gibonni/sriod-navigation/README.md

This is my part of bachelor thesis project.
