gibonni/sriod-navigation/Praćenje_magnetskog_otiska_mobilnim_robotom.pdf

### SVEUCILIŠTE U ZAGREBU ˇ FAKULTET ELEKTROTEHNIKE I RACUNARSTVA ˇ

### ZAVRŠNI RAD br. 72

# Pracenje magnetskog otiska ´

# mobilnim robotom

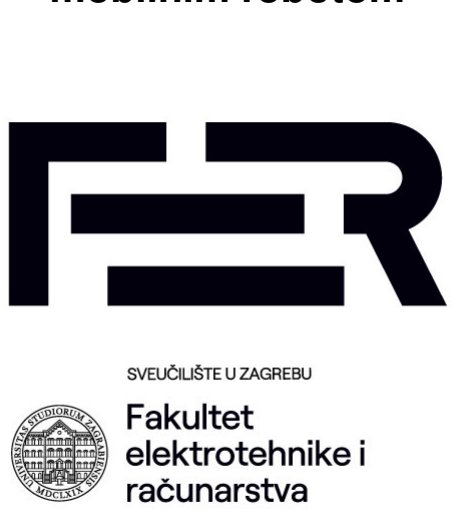
[picture p1: figure]

### Gabrijel Bioci ˇ c´

Mentor: izv. prof. dr. sc. Matko Orsag

Zagreb, ožujak 2025.

Pracenje magnetskog otiska mobilnim robotom | Gabrijel Bio ´ | ciˇ c´

## SADRŽAJ

1. Uvod | v
2. Korišteni hardver i softver | vi
3. Eksperimenti | xi
4. Zakljucak | xix ˇ
5. Sažetak | xx
Literatura | xxi
iv | SADRŽAJ

Gabrijel Biociˇ c | Pra ´ | cenje magnetskog otiska mobilnim robotom ´

# 1. Uvod

Navodenje mobilnih robota u prostoru mogu ¯ | ce je izvesti razli ´ | citim metodama. Jedna ˇ
od pouzdanih metoda koja zahtjeva intervenciju u prostoru je pracenje linije kamerom ´ na mobilnom robotu [2]. U ovom zadatku potrebno je izvesti ovaj kanonski problem upravljanja mobilnim robotom preko povratne veze temeljene na magnetskom polju. Potrebno je modificirati postojeci mobilni robot tako da ga se opremi senzorom za ´ mjerenje magnetskog polja. Robot ce morati pratiti kontinuiranu stazu sastavljenu od ´ permanentnih magneta.
Krajnji cilj zadatka je riješiti problem pracenja magnetskog otiska. Rješavanje tog ´
zadatka kasnije bi omogucilo primjenu i prilagodbu ovog rješenja na sli ´ | cne probleme. ˇ
Neki od primjera bi bili oznacavanje stanice za punjenje magnetima, ograni ˇ | cavanje po- ˇ
drucja rada magnetima kao dodatna zaštita u navigiranju samog robota u ograni ˇ | cenom ˇ
prostoru. Takoder prilikom vožnje snijeg ili bilo kakva druga sli ¯ | cna prirodna pojava ˇ
može omesti vec postoje ´ | ce sustave koji se oslanjaju na vidljive zapreke. Ti sustavi ´
mogu se unaprijediti tako da se doda i sustav pracenja magnetskog polja te se doda ´ zapreka magnetskom trakom, tako se sustav može navigirati iz više izvora [7].
POGLAVLJE 1. UVOD | v

# 2. Korišteni hardver i softver

## 2.1. Hardver

### 2.1.1. Gradiometar

Gradiometar je razvijen na Fakultetu elektrotehnike i racunarstva u laboratoriju LA- ˇ RICS [6]. Za mjerenje magnetskog polja koristi SRIOD metodu koja osim iznosa magnetskog polja može mjeriti i orijentaciju. Podatke koji se dobiju sa senzora odgo-
varaju fizikalnoj velicini gusto ˇ | ce magnetskog polja. Mjerenja CTL i CTR se koriste ´
kao ulaz u regulator. Ta mjerenja su dobivena s razlicitih pozicija na gradiometru te ˇ nam omogucuju orijentaciju u prostoru. Kako bi nam ti podaci bili korisni treba nam ´ njihova razlika.
errorz = CT L − CT R | (2.1)

Razlika iz jednadžbe (2.1) može se koristiti kao pomak robota u odnosu magnetsko polje u lijevo ili desno ovisno o predznaku rezultata. Ta brojka se kasnije koristi za racunanje potrebne brzine rotacije robota. ˇ
Senzor koristi UDP komunikaciju spojenu preko ethernet kabela na robotovo racu- ˇ nalo. Prilikom postavljanja gradiometra važno je obratiti pažnju na smjer. Na njemu je

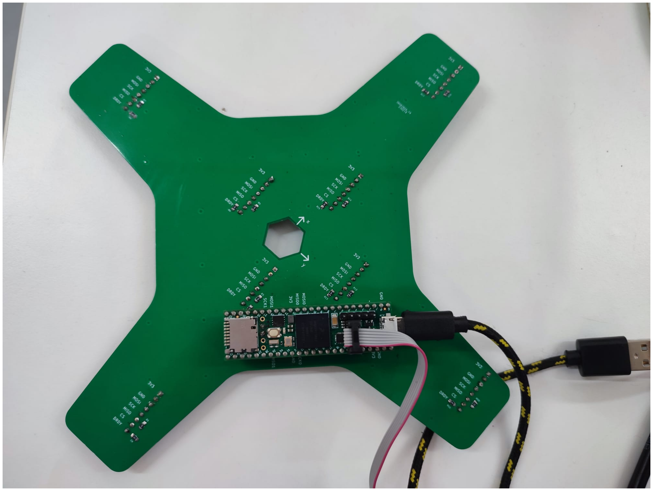
[picture p2: figure]
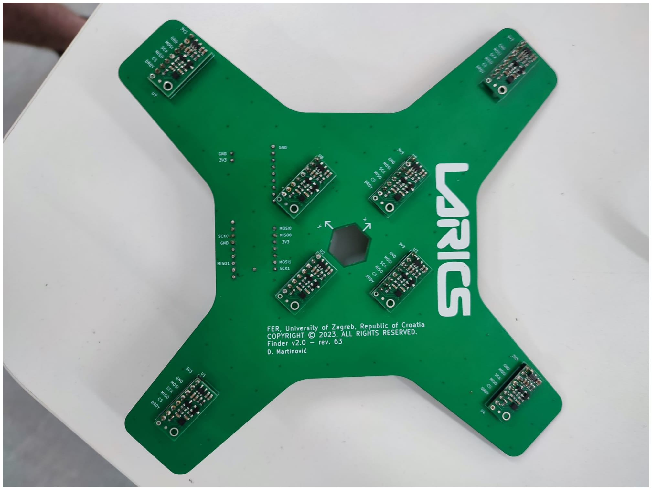
[picture p3: figure]

(a) Gornja strana s ugradbenim racunalom. ˇ | (b) Donja strana sa senzorima.

Slika 2.1: Gradiometar korišten u eksperimentima.

oznacen pozitivan smjer ˇ | x i pozitivan smjer y. Algoritam razvijen u ovom radu pret-
postavlja da se x os gradiometra postavlja u pozitivnom smjeru kretanja robota prema
vi | POGLAVLJE 2. KORIŠTENI HARDVER I SOFTVER

naprijed. Osim navedenih CTL i CTR moguce je koristiti CTU i CTD što funkci- ´ onira na slican na ˇ cin kao CTL i CTR. Razlika CTU i CTD nam govori koliko je izvor ˇ magnetskog polja udaljen po x osi. Prilikom eksperimenata postavljena je konstantna brzina prema naprijed te se koristi error_z iz jednadžbe (2.1) za skretanje lijevo ili desno.

### 2.1.2. Mobilni robot

Robot koji se koristi za eksperimente je Scout Mini od Agile X Robotics [8]. Dimenzije mobilnog robota su 612×580×245 mm, dok mu je masa 23 kg. Za komunikaciju

koristi Standard can.232 serial port te ga je moguce kontrolirati preko cmd_vel topica ´
u ROS-u. Prilikom izvodenja eksperimenata koristili su se omnidirekcionalni kota ¯ | ci. ˇ

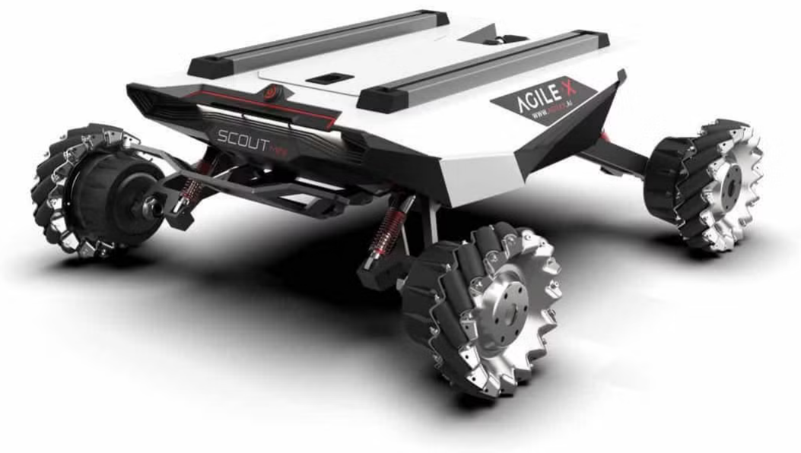
[picture p4: figure]

Slika 2.2: Scout Mini robot s omnidirekcionalnim kotacima. ˇ

### 2.1.3. Neodimijski magneti i staza

Traka 2.4 koju robot prati složena je od niza paralelnih magneta koji cine stazu ˇ koju robot mora pratiti. Svaki par magneta je udaljen 5 centimetara od drugog para magneta. Magneti [5] su zalijepljeni za pod ljepljivom trakom 2.3a. Razlog korištenja neodimijskih magneta je njihova velika snaga te zbog toga mogu lakše nadjacati ˇ smetnje.

POGLAVLJE 2. KORIŠTENI HARDVER I SOFTVER | vii

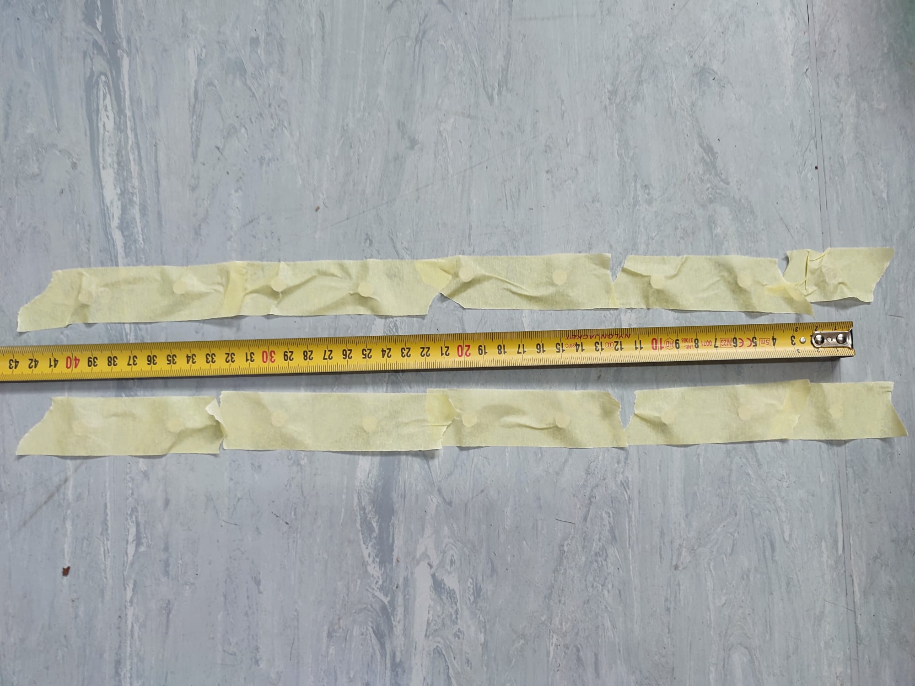
[picture p5: figure]

(a) Staza sa zaljepljenim neodimijskim magne-

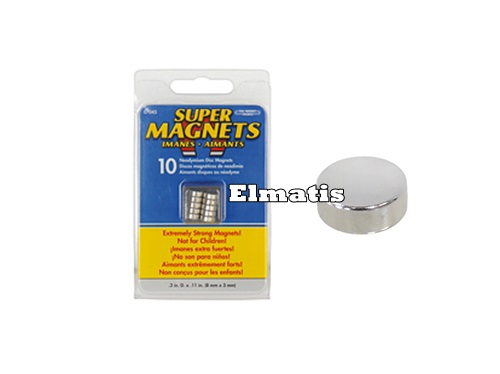
[picture p6: figure]

tima. | (b) Neodimijski magneti.

Slika 2.3: Slike staze i magneta.

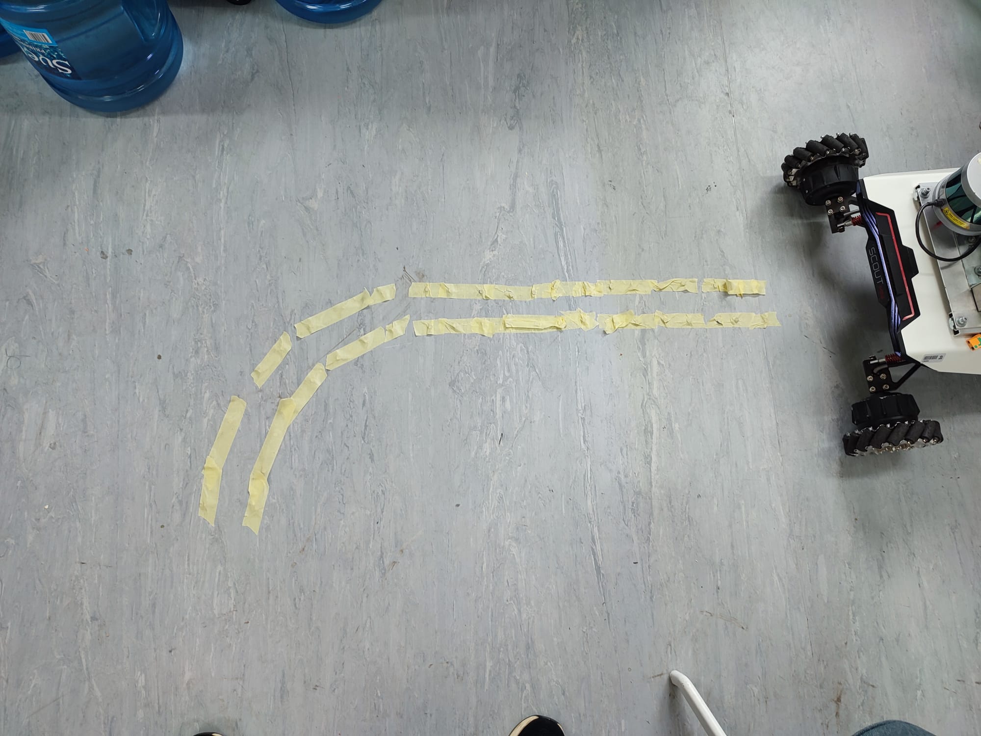
[picture p7: figure]

Slika 2.4: Staza s robotom

viii | POGLAVLJE 2. KORIŠTENI HARDVER I SOFTVER

### 2.1.4. Nastavak za gradiometar

Gradiometar stoji ispod samoga robota te od tamo mjeri sve podatke. Kako bi on tamo stajao dizajniran je nastavak prikazan na Slici 2.5c na koji se senzor može staviti i ucvrstiti. Modelirana su dva dijela. Nastavak koji se može staviti na robota te matica ˇ koja se stavlja na nastavak kako bi senzor ostao na mjestu [3]. Nastavci su dizajnirani u Autodesk Fusion 360 [1].

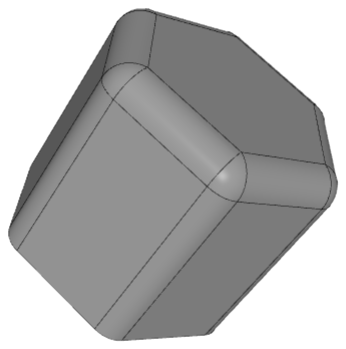
[picture p8: figure]
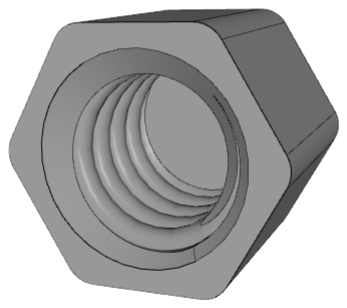
[picture p9: figure]

(a) Matica s vanjske strane. | (b) Matica s unutarnje strane.

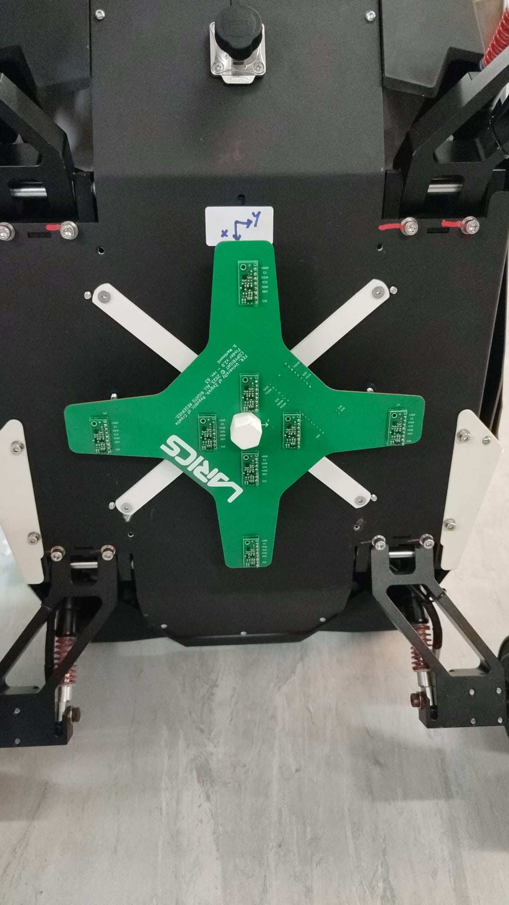
[picture p10: figure]
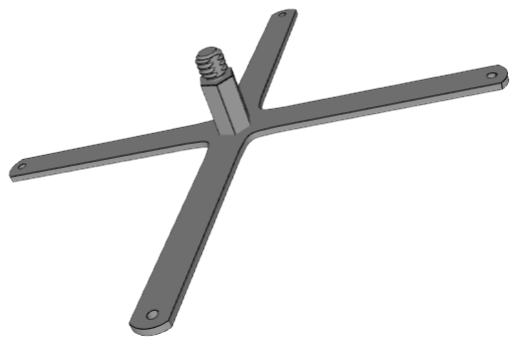
[picture p11: figure]

(c) Nastavak za gradiometar. | (d) Gradiometar na robotu.

Slika 2.5: Slike matice i nastavka za gradiometar.

POGLAVLJE 2. KORIŠTENI HARDVER I SOFTVER | ix

## 2.2. Softver

### 2.2.1. ROS

Robotski operacijski sustav [4] je skup softverskih biblioteka koji služi kako bi se
lakše izradivalo aplikacije za upravljanje robotima. Omogu ¯ | cuje jednostavan na ´ | cin za ˇ
implementaciju autonomnog nacina rada. Korištena verzija ROS-a za ovaj projekt je ˇ ROS Noetic. Napisane su dvije skripte od kojih jedna šalje podatke sa senzora na ROS topic, te druga te podatke obraduje i pretvara ih u cmd_vel. Za potrebe ovog ¯ projekta definiran je novi topic SRIOD_data na koji se šalju mjerenja senzora 2.1.1 pod nazivima CTU, CTD, CTR i CTL. S tog topica uzimaju se podatci koji se obraduju ¯ i šalju na cmd_vel koji robot 2.1.2 prima te se krece sukladno tim podatcima. ´

### 2.2.2. PID kontroler

PID (proporcionalni-integralni-derivacijski) kontroler je vrsta povratne veze koja se koristi u automatskoj regulaciji sustava kako bi se postigao željeni izlaz ili kontrola. Proporcionalni dio regulatora (Kp) reagira na trenutnu vrijednost koju sustav dobiva
u odnosu na željenu vrijednost. Što je veca greška do ja ´ | ce djeluje. Obi ˇ | cno ima najve ˇ | cu´

vrijednost. Integracijski dio regulatora tijekom vremena akumulira pogrešku i koristi
se za eliminaciju preostale greške. Omogucuje preciznije postavljanje na kona ´ | cnu ˇ
vrijednost, ali zbog njega sustav sporije reagira. Integracijski dio regulatora dodaje se po potrebi, ako želimo i kako greška u stacionarnom stanju nebi postojala. Derivacijski
dio regulatora predvida grešku u budu ¯ | cnosti u odnosu na trenutnu promjenu greške. ´
Koristi se kako bi se ubrzala reakcija sustava na grešku. Ovaj dio je jako osjetljiv te uvodi kašnjenja.
U ovome rješenju koristi se samo proporcionalni dio regulatora jer je pokazao da za potrebe eksperimenta dovoljno dobro prati referencu. S obzirom na velike kolicine ˇ šuma, derivacijski clan se isto ne koristi. ˇ

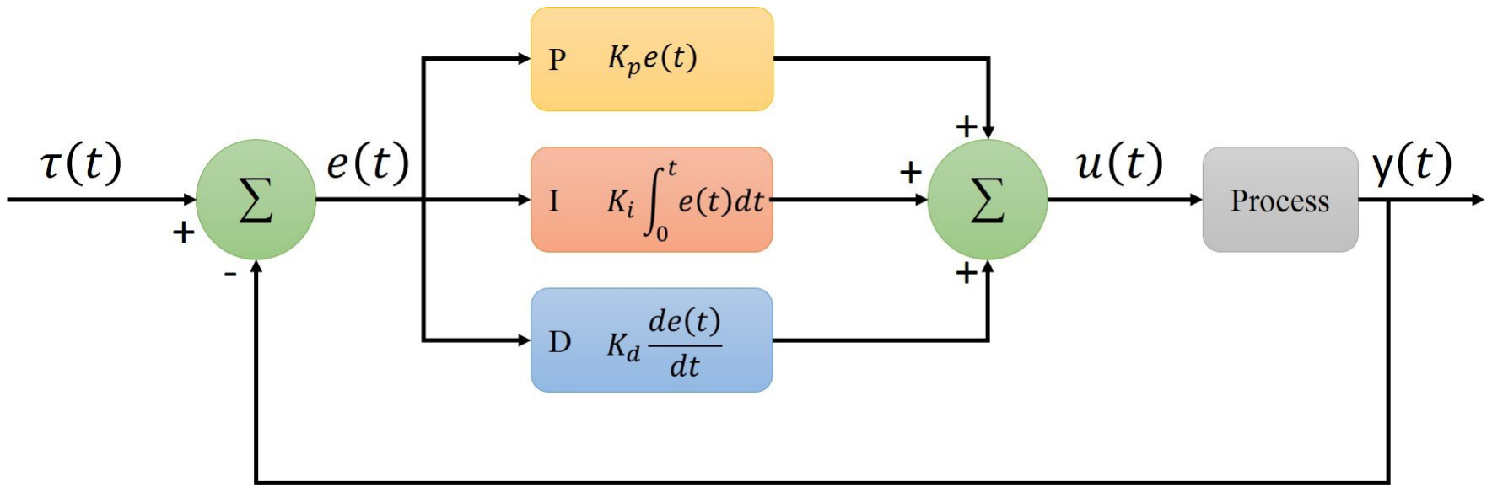
[picture p12: figure]

Slika 2.6: Blok dijagram PID kontrolera.

x | POGLAVLJE 2. KORIŠTENI HARDVER I SOFTVER

# 3. Eksperimenti

## 3.1. Postav eksperimenta

### 3.1.1. Postavljanje gradiometra

Gradiometar je postavljen tocno ispod robota 3.1. To mjesto je najprikladnije i naj- ˇ jednostavnije za postaviti senzor. Za senzor je dizajniran prikladan nastavak kako bi ga
se moglo prikvaciti za robota 2.5. U sljede ˇ | cim eksperimentima se ne koriste magneti iz ´
literature nego neki drugi znatno slabiji te nepoznatog sadržaja. Njih je više spojeno te
cine cilindar te stoga imaju ja ˇ | cu snagu skupa nego jedan neodimijski magnet. Rezultati ˇ
ovih eksperimenata koriste se u softverskoj obradi šuma.

Slika 3.1: Senzor montiran na robotu.

Senzor je jako osjetljiv na promjene te stoga osjetljiv i na šum. Zbog toga su provedena mjerenja kako bi se vidjelo na koji nacin utje ˇ ce okolina, elektromotori na ko- ˇ tacima te to usporedili s mjerenjima kada se senzor nalazi blizu magneta. Provedeni ˇ eksperimenti su samo vožnja po podu, podizanje robota u zrak i kretnje kotaca, stajanje ˇ robota uz pomicni magnet u zraku i na podu te vožnja preko magneta. Iz tih ekspe- ˇ

POGLAVLJE 3. EKSPERIMENTI | xi

rimenata zakljuceno je da je omjer mjerenja smetnje i mjerenja s magnetom dovoljno ˇ velik da senzor može ostati ispod robota i biti korišten za navigaciju.

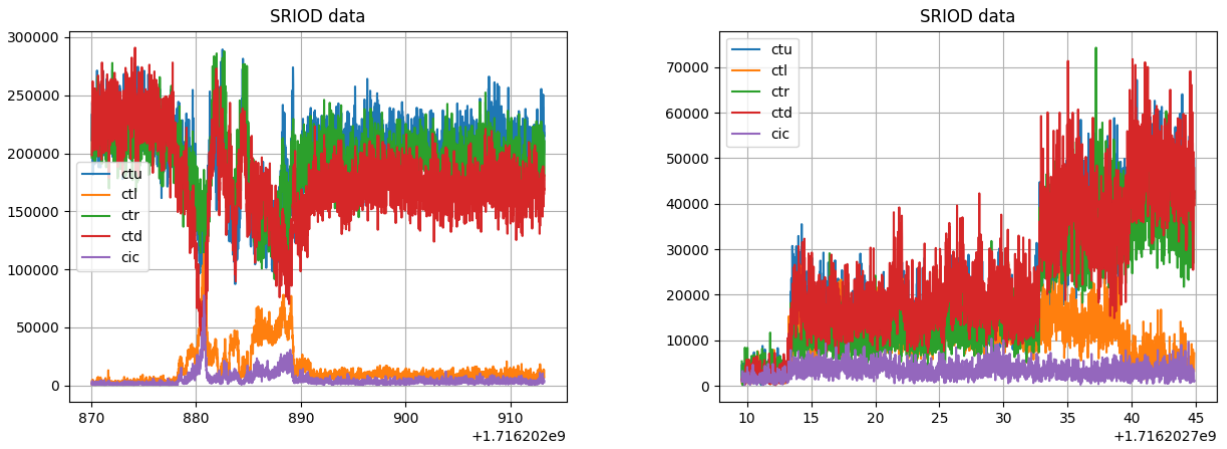
[picture p13: figure]

(a) Vožnja po podu. | (b) Robot u zraku.

Slika 3.2: Mjerenja šuma motora robota.

Na slici 3.2b može se vidjeti da dok je robot u zraku maksimalna razina šuma dolazi na razinu do oko 8·10⁵ dok u eksperimentu vožnje po podu 3.2a dolazi i do 3·10⁶
. Može
se zakljuciti da bez prisutnosti nekog magnetskog materijala šum ne ˇ | ce prije ´ | ci razinu ´
4 · 10⁶
te kasnije u upravljanju sva mjerenja koja su manja od toga se mogu zanemariti. Sljedeci provedeni eksperimenti su napravljeni kako bi se provjerio utjecaj magneta ´ na senzor te kolika je razlika izmedu mjerenog utjecaja magneta i šuma. Robot je bio ¯ odignut od poda na dovoljnu razinu da okolina ne utjece na signal te se magnetom ˇ prošlo ispod robota oko podrucja senzora. ˇ

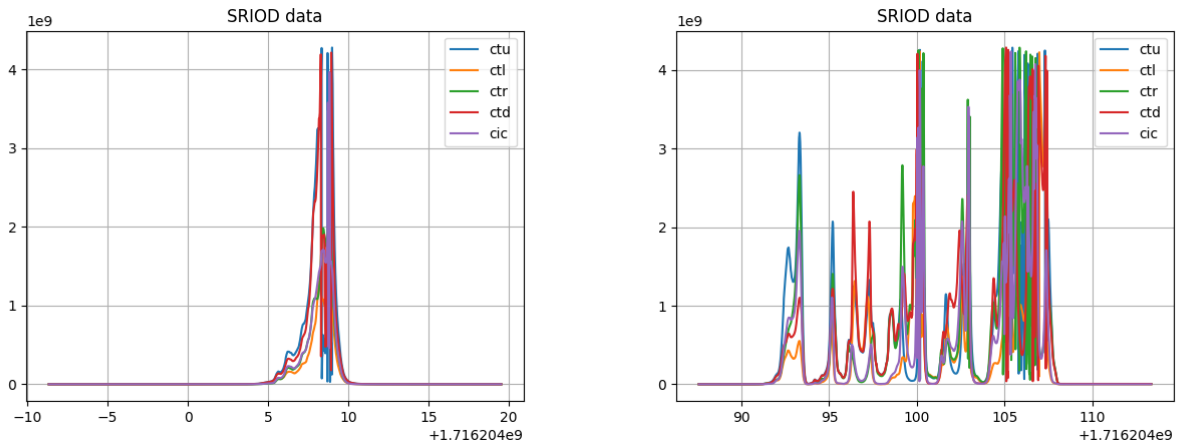
[picture p14: figure]

(a) Zrak s magnetom. | (b) Zrak s pomicnim magnetom. ˇ

Slika 3.3: Eksperiment s magnetom i robotom u zraku.

Eksperiment 3.3a proveden je tako da je robot bio statican podignut u zrak dok se ˇ magnet približavao do senzora i nazad. Iz podataka se može vidjeti neka maksimalna vrijednost mjerenja dolazi do razine 4.5 · 10⁹
. te da magnet utjece dovoljno jako da ˇ
xii | POGLAVLJE 3. EKSPERIMENTI

šum nije relevantan. Drugi eksperiment koji je proveden 3.3b je slican, samo osim ˇ približavanja magneta senzoru magnet se pomicao u raznim smjerovima kako bi se
vidjelo da magnet ne utjece previše na senzor i da može mjeriti razliku na razli ˇ | citim ˇ
pozicijama. Ovdje takoder mjerenja dosežu neku maksimalnu vrijednost od ¯ | 4.5 · 10⁹
te
je zakljuceno da senzor može raspoznati poziciju magneta. Idealan omjer šuma 3.1.1 i ˇ
signala u ovom slucaju iznosi 30.51dB što daje odli ˇ | cne uvjete za navigaciju robotom. ˇ
Sljedeci eksperimenti koji su provedeni su sli ´ | cni, ali s robotom na podu. Ovi eksperi- ˇ
menti su provedeni kako bi se vidjelo kakav ce omjer šuma i signala biti u stvarnom ´
slucaju kada ˇ | ce se robot sam voziti te upravljati mjerenjima dobivenog signala te ho ´ | ce´
li šum utjecati na putanju. Kao prvi eksperiment robot se vozi po podu se prelazi preko magneta kako bi se izmjerio signal te vidjela razlika izmedu signala pri vožnji ¯ bez magneta ispod robota te sa magnetom. Drugi provedeni eksperiment postavlja robota u stacionarno stanje te se magnet rukom pomice ispod senzora. Taj eksperiment ˇ se provodio kako bi se potvrdili rezultati prethodnog eksperimenta i konacno utvrdio ˇ omjer signala i šuma.

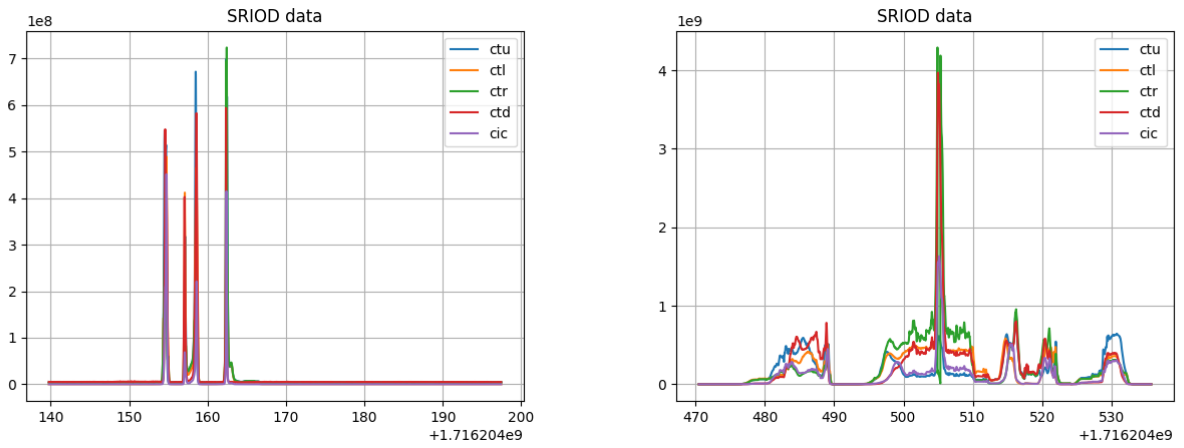
[picture p15: figure]

(a) Vožnja preko magneta. | (b) Približavanje magneta senzoru.

Slika 3.4: Eksperiment s magnetom i robotom na podu.

U eksperimentu vožnje preko magneta 3.4a možemo vidjeti da se vrlo jasno vidi kada robot prelazi preko magneta. U tim trenutcima signal dolazi do razine od 5.5 · 10⁸ do 7.5 · 10⁸ ovisno o tome koliko blizu je bio sam magnet senzoru. Takoder se ovdje ¯

vidi pad signala za red jedne velicine. Iz tih podataka omjer šuma 3.1.1 i signala iznosi ˇ 22.11dB za iznos signala 6.5·10⁸
što i dalje daje dobar omjer za autonomno upravljanje vozilom. U drugom eksperimentu 3.4b potvrduje se da je šum zanemariv u odnosu na ¯ signal kada se senzor nalazi u blizini magneta.
POGLAVLJE 3. EKSPERIMENTI | xiii

## 3.2. ROS i PID

Robot se upravlja preko cmd_vel topica te je za to napisana skripta SriodNaviga-
tion.py. Prvo je u ROS implementiran vec postoje ´ | ci kod za dobivanje podataka [6] sa ´
senzora te je za te podatke napisan poseban topic na koji ce se slati mjerenja. Podaci ´ se obraduju u skripti SriodNavigation.py u kojoj je implementiran PID kontroler te se ¯
kasnije šalju na cmd_vel. Iz sljedecih eksperimenata zaklju ´ | ceno je da je dovoljan samo ˇ
proporcionalni dio regulatora.

### 3.2.1. Staza

Staza 3.5b koju robot treba prijeci napravljena je od neodimijskih magneta zalijep- ´ ljenih trakom za pod. Svakih 5 cm postavljen je jedan par magneta. Na stazi postoji jedan ravan dio koji se kasnije nastavlja u luk. Za robota je potrebno da taj dio prode od ¯ pocetka do kraja bez da skrene u nekom drugome smjeru. Samo ravni dio staze koris- ˇ tio se za grubo odredivanje proporcionalnog dijela regulatora te se kasnije s dodanim ¯ zavijutkom preciznije odredio taj parametar.

(a) Staza sa neodimijskim magnetima. | (b) Staza s kružnim lukom.

Slika 3.5: Slike staze korištene u eksperimentima.

### 3.2.2. P regulator

P regulator reagira na trenutna mjerenja te je za njegovo odredivanje bitno na koji ¯ koliko se brzo robot krece. Za sporije linearno kretanje potrebna je manja vrijednost, ´
dok za vece brzine i ve ´ | ca vrijednost parametra. Za odre ´ | divanje K ¯ | p prvo je postav-
ljen brzina u pozitivnom x smjeru da bude konstantna. Cmd_vel.x je postavljen na
0.25. Zatim se pri toj brzini odredivao K ¯ | p. Provedeno je više mjerenja kako bi se naj-
preciznije odredila vrijednost parametra. Prilikom prikupljanja podataka uzimale su se
xiv | POGLAVLJE 3. EKSPERIMENTI

vrijednosti koje dolaze direktno sa senzora i s njima racunala greška 2.1 te sama greška ˇ koju je robot koristio.
Red velicine parametra prvo je odre ˇ | den empirijskim metodama dok robot nije mo- ¯
gao dovoljno dobro slijediti ravnu stazu magneta. Duljina staze je bila postavljena na
65 cm prilikom odredivanja parametra te je robot morao mo ¯ | ci pro ´ | ci cijelu duljinu staze ´
bez da promijeni smjer kretanja. Red velicine odre ˇ | den je na ¯ | 10⁻⁷
te se od toga dalje
nastavilo na preciznije odredivanje parametra. Na stazu je dodan kružni luk 3.5 koji ¯
je omogucavao preciznije odre ´ | divanje K ¯ | p. Testirani parametri su 3 · 10⁻⁷

, 3.5 · 10⁻⁷
,
4·10⁻⁷

, 4.5·10⁻⁷

i 5·10⁻⁷ pri cemu su najbolji rezultati postignuti za vrijednost ˇ | 4·10⁻⁷
U ostalim rezultatima robot bi ili previše ili premalo reagirao na razliku mjerenja sa senzora. Error ili greška se racuna po formuli 2.1 te se direktno množi s parametrom ˇ Kp. Ta greška nam govori koliko je sam senzor udaljen od izvora magnetskog polja, u našem slucaju magneta na stazi. Na tu grešku robot treba reagirati i ispraviti putanju ˇ kako bi se kretao po stazi. Ovdje 3.6 se mogu vidjeti odzivi robota u odnosu na signal sa senzora. Na grafovima 3.6 može se vidjeti greška i za tu grešku izracunata kutna ˇ brzina kretanja samog robota. Prilikom dolaska na luk robot ne uspijeva pravovremeno reagirati. To dovodi do izbacivanja robota sa same putanje i neželjenog ponašanja. Za Kp = 4 · 10⁻⁷
robot uspijeva savladati luk i pratiti stazu zadanu magnetima.
POGLAVLJE 3. EKSPERIMENTI | xv

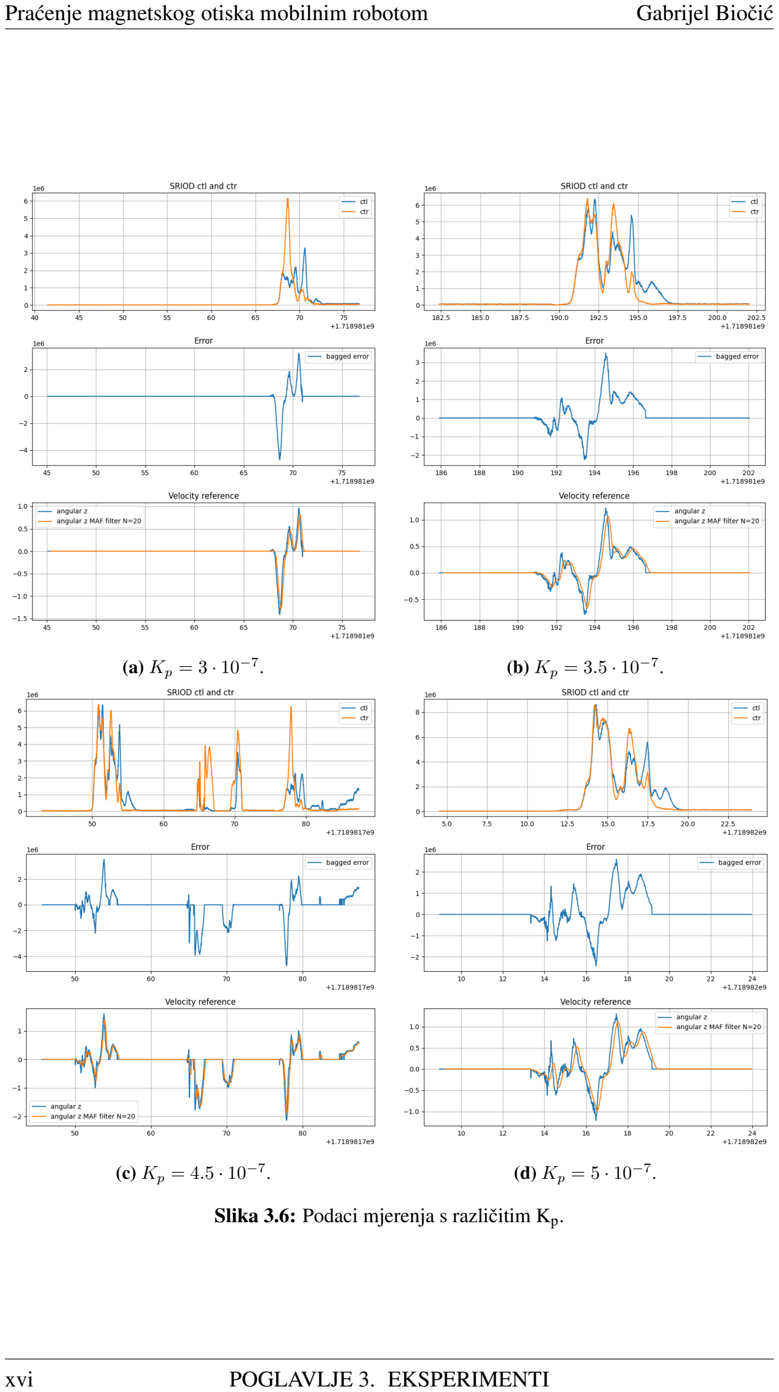
[picture p16: page 14]

(a) Kp = 3 · 10⁻⁷
. | (b) Kp = 3.5 · 10⁻⁷
(c) Kp = 4.5 · 10⁻⁷
. | (d) Kp = 5 · 10⁻⁷
Slika 3.6: Podaci mjerenja s razlicitim K ˇ | p.
xvi | POGLAVLJE 3. EKSPERIMENTI

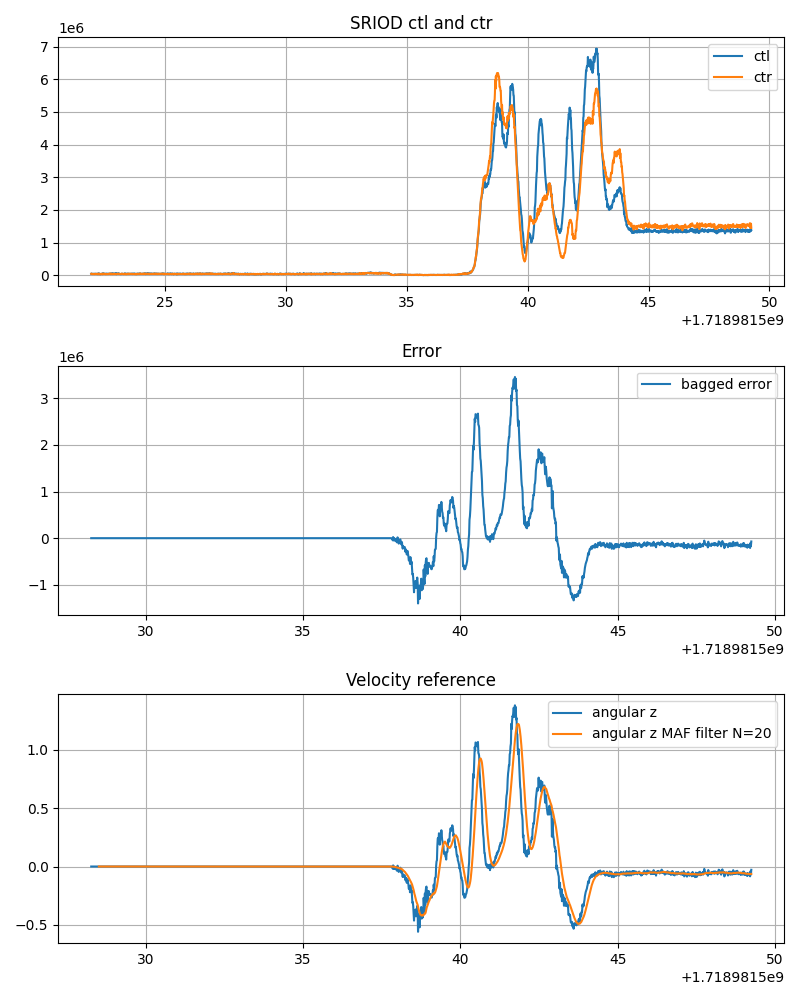
[picture p17: figure]

Slika 3.7: Kp = 4 · 10⁻⁷

Na grafu 3.7 Error vidi se da se izracunati i stvarni error potpuno poklapaju te da ˇ robot može pratiti stazu. S ovom vrijednosti parametra ne treba implementirati integralni dio ni derivacijski dio PID parametra jer robot sam može dovoljno precizno pratiti stazu. Osim PID regulatora implementirani su drugi dodatni filtri koji omogucuju bolje ponašanje robota. ´

### 3.2.3. MAF i minimalna vrijednost

Šum u kontroli stvara neželjene vrijednosti koje se propagiraju u konacnici kao grubi ˇ

i oštri pomaci robota. Kako bi se to uklonilo implemetirano je filtriranje na temelju minimalne vrijednosti koja se empirijski odredila sa grafa 3.2a. Razlog ovakvom ponasanju je da na gradiometru nije svaki senzor jednako otporan na šum. U slucaju ovog ˇ

POGLAVLJE 3. EKSPERIMENTI | xvii

rada, minimalna vrijednost je 4 · 10⁶ 3.1.1. Ako je vrijednost koju senzor manja od za-

dane onda ju postavlja u 0. U tom slucaju dok se robot ne nalazi blizu magneta kretat ˇ ce se samo ravno. Rad ovog filtra može se dobro vidjeti an grafu Error za vrijednost ´ proporcionalnog parametra 4.5 · 10⁻⁷ 3.6c gdje u trenutku kada robot skrene sa staze i

odmakne se od magneta brzina mu se ruši u 0.
Druga stvar koja je implementirana je MAF (engl. Moving Average Filter). Filtar radi tako da zbraja N prošlih vrijednosti i racuna njihov prosjek. Tako filtar filtrira ˇ
šum i omogucava gla ´ | di prijelaz brzine i pritom putanje. Zbog toga što zbraja prošle ¯
vrijednosti filter u sustav dovodi vremensko kašnjenje. U našem sustavi to vremensko kašnjenje može se vidjeti na grafu Velocity reference 3.7 gdje filter jako zagladuje ¯ prijelaz brzine, ali pritom žrtvuje vrijeme reakcije te dodaje dodatno kašnjenje u sustav.

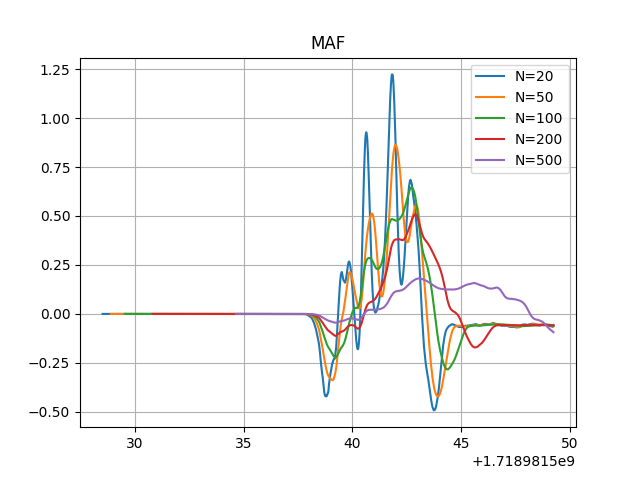
[picture p18: figure]

Slika 3.8: MAF filter za Kp = 4 · 10⁻⁷ .

Na grafu 3.8 mogu se vidjeti razni odzivi brzine uz razlicite veli ˇ | cine za ˇ | N. Kako
se povecava ´ | N tako kašnjenje raste, kvaliteta odziva pada te se najbolja velicina za ˇ
implementaciju cini ˇ | N = 20. Pri tom N kašnjenje nije veliko i šum se dobro filtrira te
je odziv i dalje dobar te se može koristiti za ugladenije upravljanje robotom 3.7. ¯
xviii | POGLAVLJE 3. EKSPERIMENTI

# 4. Zakljucak ˇ

Moguce je izvesti pra ´ | cenje magnetskog otiska uz pomo ´ | c gradiometra i povratne veze ´
magnetskim poljem. U ovoj izvedbi korišten je omnidirekcionalan robot te je kontrolirano njegovo rotiranje oko z osi. Brzina prema naprijed je bila konstantna od 0.25 u jedinicama ROS-a. U upravljanju je implementirana granica 3.2.3 koju senzor mora poslati da bi se smatrala valjanom jer je sam podložan šumu. Za samo upravljanje koristi se P regulator. Proporcionalni parametar iznosio je 4 · 10⁻⁷
. Pri toj vrijednosti
robot je mogao pratiti stazu s lukom na kraju 3.5b. Testirani su i drugi parametri no pri njima robot nije uspio savladati kružni luk. Prilikom obrade podataka implementiran je i MAF 3.8 kako bi se izgladila putanja robota. Takva putanja u odziv dodaje kašnje-
nje reakcije no filtrira vecinu šuma koji mjeri senzor. Najbolja vrijednost za koli ´ | cinu ˇ
parametara koji ulaze za filtar je 20 3.7. Za tu vrijednost robot i dalje ima dovoljno dobar odziv te se umanjuje komponenta šuma u odzivu što kao rezultat daje fluidnije kretanje robota. Kao daljnje eksperimente potrebno je mjeriti odzive u slucaju da se ˇ robota odgurne sa staze te takoder napraviti dulju stazu. Iz tih podataka potrebno je ¯ vidjeti treba li dodatno implementirati integracijski i derivacijski dio kako bi se odziv poboljšao.
POGLAVLJE 4. ZAKLJUCAK | xix ˇ

# 5. Sažetak

Za rješavanje problema pracenja magnetskog otiska potreban je gradiometar i mo- ´ bilni robot. U rješavanju ovog konkretnog problema korišten je omnidirekcionalni robot Scout Mini te gradiometar za mjerenje magnetskog polja magneta. Za stazu se koriste neodimijski magneti zbog njihovog jakog magnetskog polja. Magneti su bili postavljeni u parovima svakih 5 centimetara. Nastavak kojim bi se gradiometar za pra-
cenje polja prikva ´ | cio za robota dizajniran je u Autodesk Fusionu te 3D printan. Sama ˇ
kontrola robota izvedena je u ROS-u P regulatorom. Takoder je napravljena obrada ¯ podataka MAF filterom kako bi se izgladila putanja te potencijalno implementiralo u
buducem razvijanju. Njegova implementacija zagla ´ | duje putanju i reakciju te donosi ¯
komponentu kašnjenja u odziv.
xx | POGLAVLJE 5. SAŽETAK

## LITERATURA

[1] Autodesk. Autodesk fusion 360, 2024. URL https://www.autodesk.

com/products/fusion-360/overview?term=1-YEAR&tab= subscription&plc=FSN. (https://www.autodesk.com/products/fusion-360/overview?term=1-YEAR&tab=subscription&plc=FSN) available: 14.8.2024.

[2] Yougang Bian, Jieyun Ding, Manjiang Hu, Qing Xu, Jianqiang Wang, i Keqiang Li. An advanced lane-keeping assistance system with switchable assistance modes. IEEE Transactions on Intelligent Transportation Systems, 21:385–396, 01 2020. doi: 10.1109/TITS.2019.2892533.
[3] Gabrijel Biociˇ c. Github repository, 2024. URL ´ | | https://github.com/

gibonni/sriod-navigation. (https://github.com/gibonni/sriod-navigation) available: 14.8.2024.

[4] Open Source Robotics Foundation. Robot operating system (ros), 2024. URL https://www.ros.org/. available: 14.8.2024.
[5] Super magnets. Neodimijski magnet, 2024. URL https://elmatis.hr/

ProductDetails.aspx?productId=50653. (https://elmatis.hr/ProductDetails.aspx?productId=50653) available: 14.8.2024.

[6] Dean Martinovic, Jelena Vuleti ´ | c, Dario Stuhne, Matko Orsag, i Zdenko Kova ´ | ciˇ c.´
Object localization by construction of an asymmetric isobody of the magnetic gradient tensor contraction using two identical permanent magnets. IEEE transactions on magnetics, 59(4):1–9, 2023.
[7] National Safety Council and University of Iowa. | Lane keeping assist - my
car does what? | https://mycardoeswhat.org/safety-features/
lane-keeping-assist/, (https://mycardoeswhat.org/safety-features/lane-keeping-assist/) 2024. Accessed: 2024-08-14.
[8] AgileX Robotics. Scout mini, 2024. URL https://global.agilex.ai/products/scout-mini. (https://global.agilex.ai/products/scout-mini) available: 14.8.2024.
LITERATURA | xxi
