gibonni/sriod-navigation/Nastavak za gradiometar.step

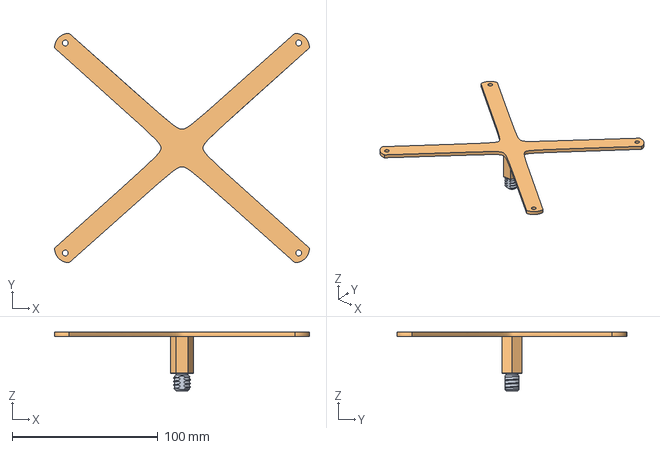
[picture p19: CAD file, 2024-08-14]
Nastavak za gradiometar.step
174.9 x 157.4 x 40.2 mm
Vijak v1
gotova_komponenta
