gibonni/sriod-navigation/Matica v1.step

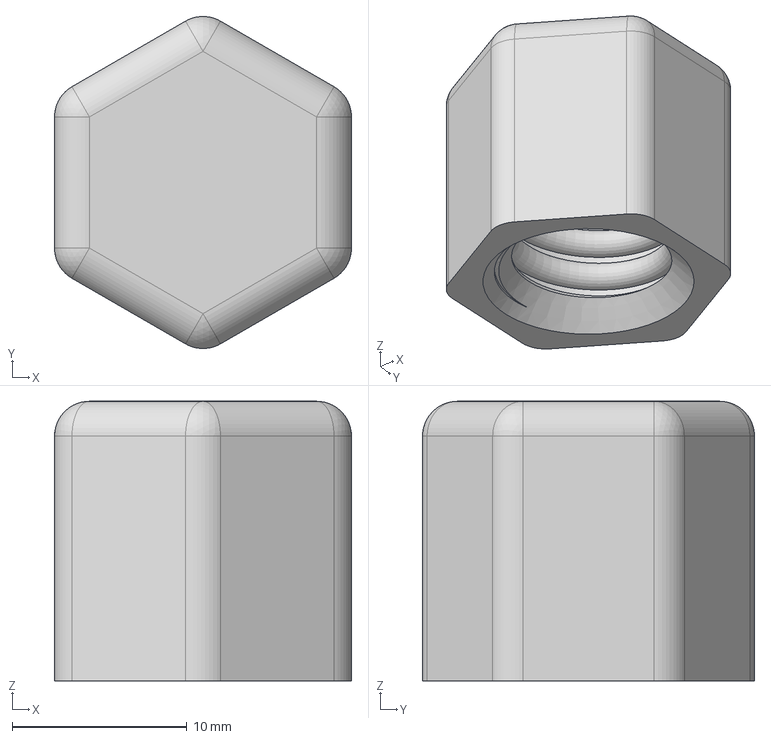
[picture p20: CAD file, 2024-08-14]
Matica v1.step
17.0 x 19.0 x 16.0 mm
